luis199421/fuckhp/host/README.md

# freejet (host driver)

Python package that drives the FreeJet FJ-2 over USB. See `../docs/06-host-driver.md`.

```bash
pip install ./host[pdf]
freejet print document.pdf
```
