luis199421/fuckhp/docs/bom.csv

group | qty | part | spec | approx_usd_total | notes
mechanical | 3 | Smooth rod | 8 mm x 400 mm (500 mm for black + colour) | 7.50 | 2 carriage rails + the feed roller shaft
mechanical | 3 | Linear bearing | LM8UU | 2.00 | carriage
mechanical | 2 | Ball bearing | 608ZZ (8x22x7) | 1.00 | feed roller shaft
mechanical | 2 | Stepper motor | NEMA17, 34-40 mm, 1.8 deg, >=0.3 Nm | 18.00 | carriage and paper feed
mechanical | 2 | GT2 pulley | 20T, 5 mm bore, 6 mm belt | 3.00 | on the two motors
mechanical | 1 | GT2 idler | 20T toothed, 5 mm bore | 1.50 | carriage belt
mechanical | 1 | GT2 belt (open) | 6 mm, 1 m | 3.00 | carriage
mechanical | 1 | GT2 belt (closed loop) | 6 mm, 200 mm length | 1.50 | feed: motor 20T -> printed 60T on the roller
mechanical | 1 | Spring steel strip | 0.3 mm x 10-12.7 mm feeler-gauge strip, 25 cm | 3.00 | cut 4 leaves x 52 mm: they press the paper onto the roller
mechanical | 1 | Screw kit | M3 socket head x 8/12/16/20, ~40 M3 nuts, 6x M3x8 set screws; M2.5 x 6 self-tapping x4 | 5.00
mechanical | 1 | M5 bolt | M5 x 30 + nut + 2 washers | 0.50 | idler axle
mechanical | 1 | Extension spring | ~5 x 25 mm, light | 0.30 | returns the cap sled
mechanical | 2 | Lever microswitch | KW11-3Z with ~28 mm lever | 1.50 | home + paper sensor
mechanical | 1 | Push button | 12 mm panel button | 0.50 | front panel
mechanical | 1 | LED | 5 mm + 330 ohm | 0.20 | front panel
mechanical | 1 | Filament | PETG ~0.75 kg + TPU ~20 g | 14.00 | TPU: tires, cap, wiper, clamp pad
electronics | 1 | Raspberry Pi Pico 2 | RP2350 | 5.00
electronics | 2 | Stepper driver | TMC2209 StepStick (MS1/MS2 high = 1/16) | 8.00 | A4988 also works (louder)
electronics | 2 | Capacitor | 100 uF 25 V | 0.40 | one per stepper driver
electronics | 1 | Power supply | 12 V 5 A brick + 5.5x2.1 mm jack | 10.00
electronics | 2 | Buck module | MP1584, set to 5.0 V and 9.0 V | 2.00
electronics | 1 | Boost module | MT3608, set to 16.0 V | 1.00 | cartridge heater rail
electronics | 1 | P-MOSFET + NPN | IRF9540N + 2N3904 | 0.90 | switches the 16 V rail
electronics | 2 | Level shifter | CD4504BE (DIP-16) | 1.50 | 9 V and 16 V cartridge signals
electronics | 4 | Heater switch | AO3401A on SOT-23 adapter + 2N7000 | 1.20 | F3/F5 of each cartridge
electronics | 2 | Monostable | 74HCT123 (DIP-16) | 0.60 | heater pulse limiter (max ~3 us)
electronics | 1 | AND gate | 74HCT08 (DIP-14) | 0.20
electronics | 1 | Protection | 3 A polyfuse, 1N5822, 1N5819 | 0.60
electronics | 1 | Passives | resistors, 470 uF 25 V low-ESR, 10 uF, 100 nF, 680 pF C0G | 2.00
electronics | 1 | Board and connectors | 90 x 70 mm perfboard, JST-XH, headers | 3.00
electronics | 1 | Contact flex + cable | salvaged from a dead HP DeskJet 2130/2630/3630/4520 (or bought as a carriage spare part) | 0.00 | see 03-electronics.md
consumable | 1 | Black cartridge | HP 302 / 63 black (or XL) | 15.00 | refillable
consumable | 1 | Colour cartridge (optional) | HP 302 / 63 tri-colour (or XL) | 18.00 | for colour printing
