luis199421/fuckhp/cad/stl-kcmy/x_motor_bracket.stl

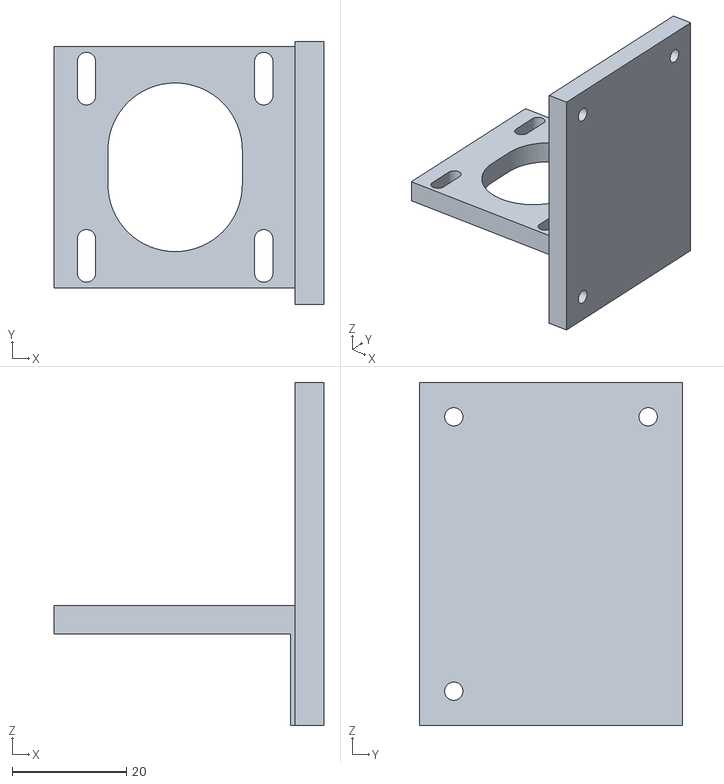
[picture p3: CAD file, 2026-11-01]
cad/stl-kcmy/x_motor_bracket.stl
47.1 x 46.0 x 60.0
