luis199421/fuckhp/cad/stl/leaf_clamp.stl

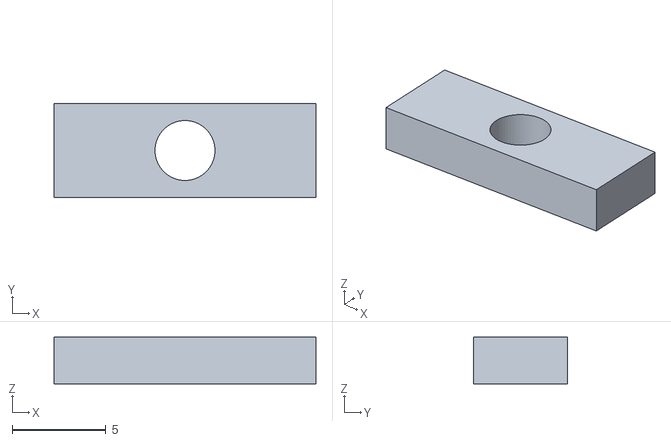
[picture p4: CAD file, 2026-11-01]
cad/stl/leaf_clamp.stl
14.0 x 5.00 x 2.50
