luis199421/fuckhp/cad/stl-kcmy/platen_1.stl

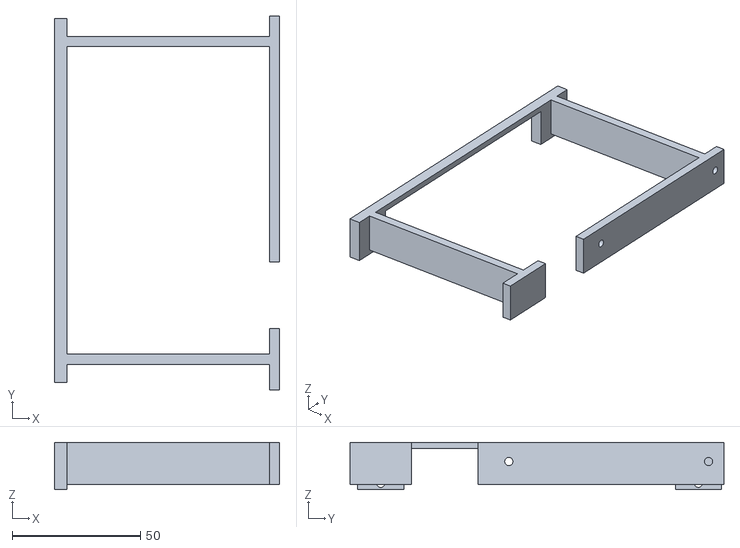
[picture p5: CAD file, 2026-11-01]
cad/stl-kcmy/platen_1.stl
88.0 x 146.0 x 18.5
