luis199421/fuckhp/cad/stl/roller_hub.stl

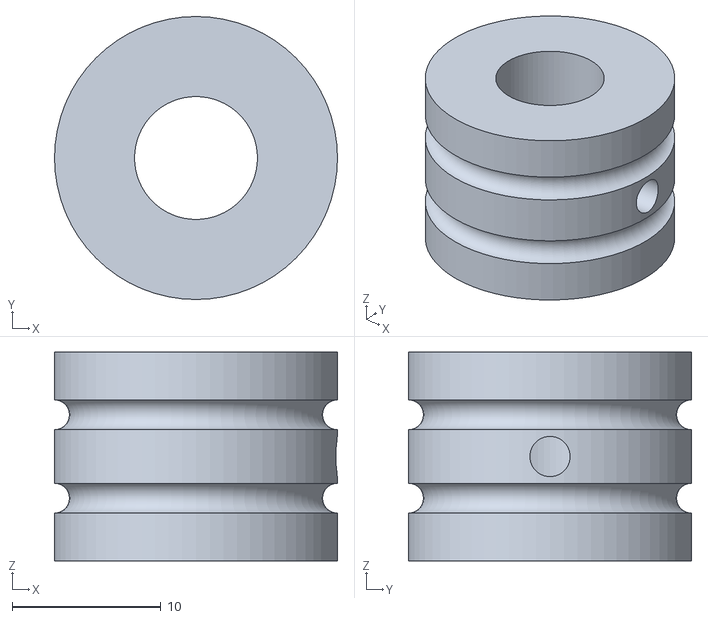
[picture p6: CAD file, 2026-11-01]
cad/stl/roller_hub.stl
19.0 x 19.0 x 14.0
