luis199421/fuckhp/cad/stl-kcmy/roll_core.stl

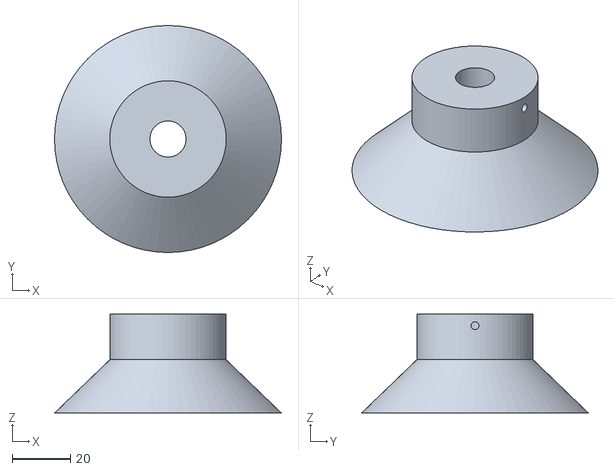
[picture p7: CAD file, 2026-11-01]
cad/stl-kcmy/roll_core.stl
78.0 x 78.0 x 34.0
