luis199421/fuckhp/cad/stl/leaf_bar_2.stl

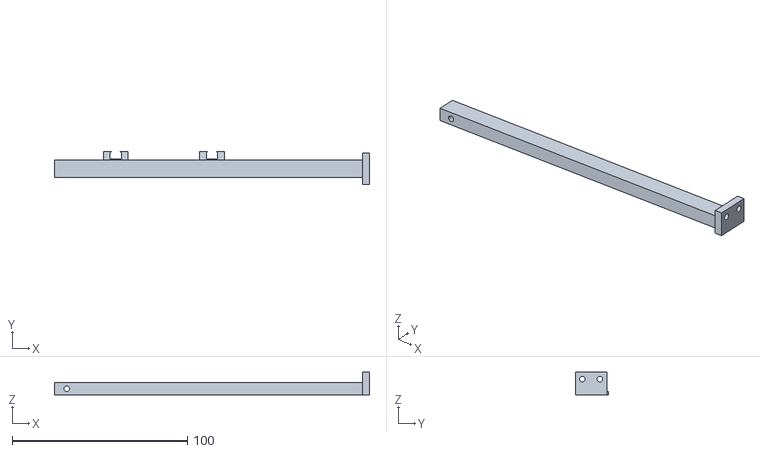
[picture p8: CAD file, 2026-11-01]
cad/stl/leaf_bar_2.stl
180.0 x 19.0 x 13.0
