luis199421/fuckhp/cad/stl-kcmy/platen_3.stl

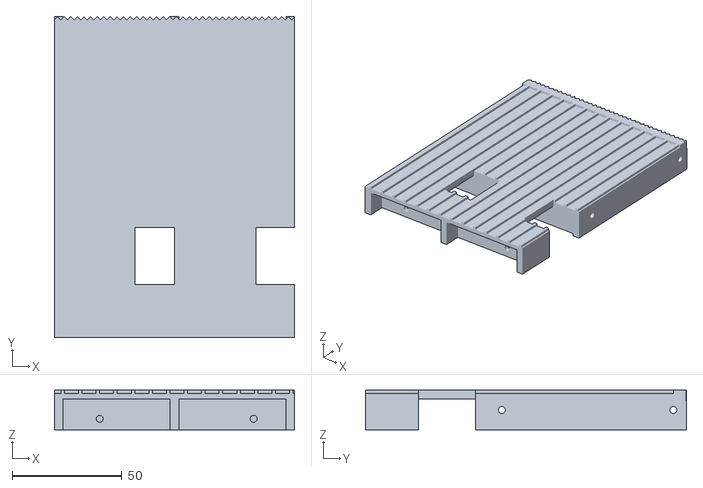
[picture p9: CAD file, 2026-11-01]
cad/stl-kcmy/platen_3.stl
109.3 x 146.0 x 18.0
