luis199421/fuckhp/cad/stl/leaf_bar_1.stl

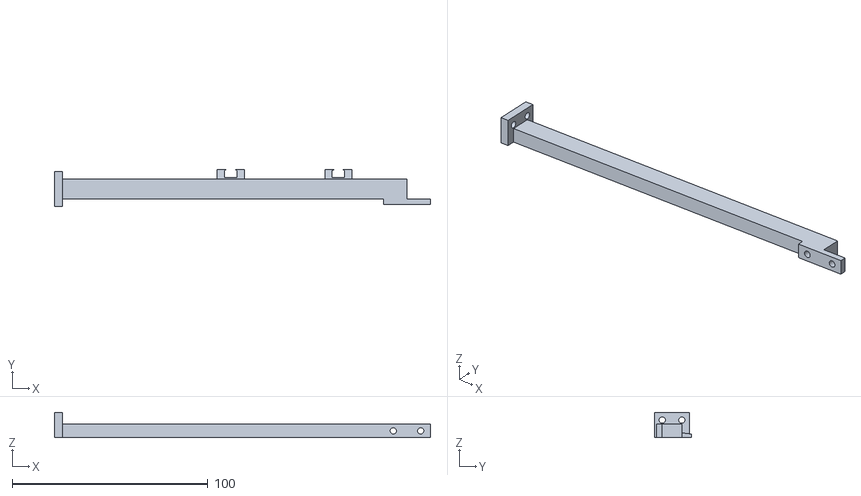
[picture p10: CAD file, 2026-11-01]
cad/stl/leaf_bar_1.stl
192.0 x 19.0 x 13.0
