luis199421/fuckhp/cad/stl-kcmy/carriage.stl

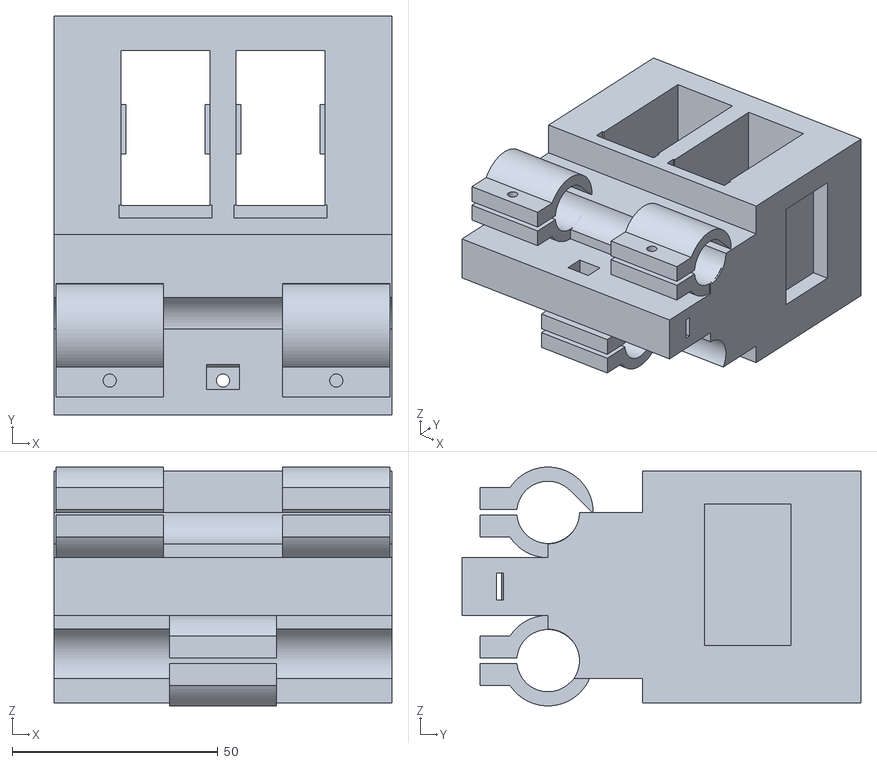
[picture p11: CAD file, 2026-11-01]
cad/stl-kcmy/carriage.stl
82.0 x 96.9 x 58.0
