luis199421/fuckhp/cad/stl/service_station_base.stl

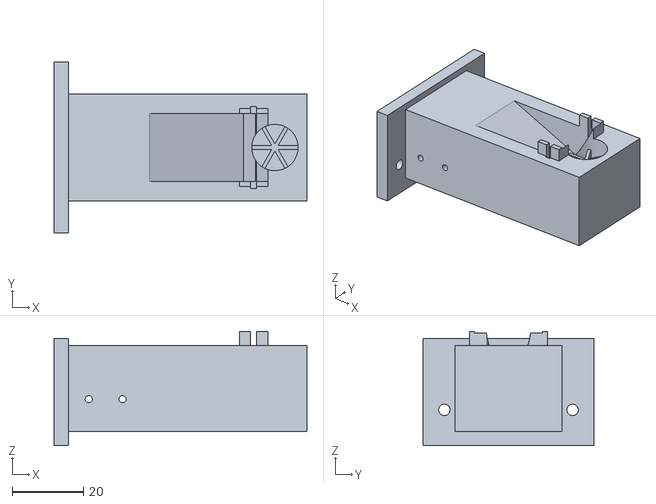
[picture p12: CAD file, 2026-11-01]
cad/stl/service_station_base.stl
71.0 x 48.0 x 32.0
