luis199421/fuckhp/cad/stl-kcmy/electronics_tray.stl

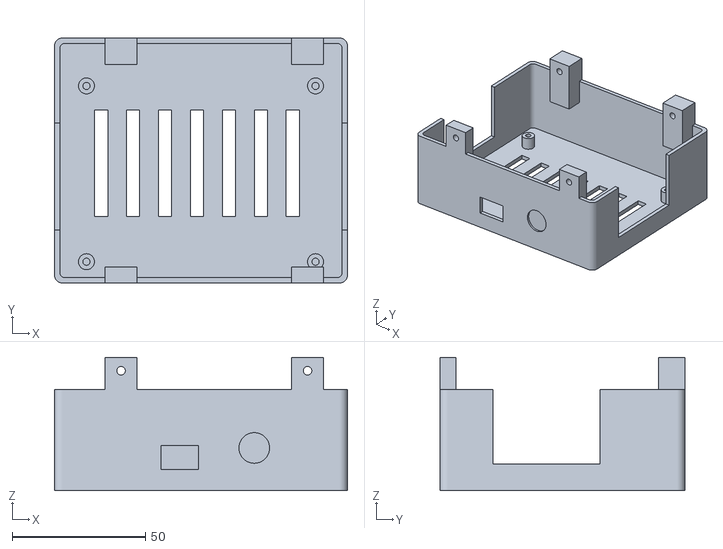
[picture p13: CAD file, 2026-11-01]
cad/stl-kcmy/electronics_tray.stl
110.0 x 92.0 x 50.0
