luis199421/fuckhp/cad/stl/tray_bracket.stl

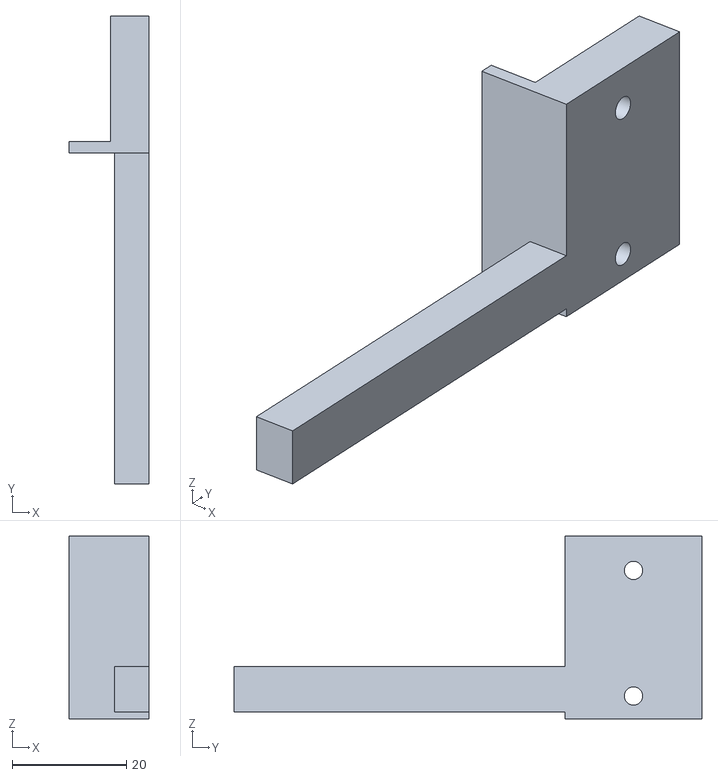
[picture p14: CAD file, 2026-11-01]
cad/stl/tray_bracket.stl
14.0 x 82.0 x 32.0
