luis199421/fuckhp/cad/stl-kcmy/service_station_sled.stl

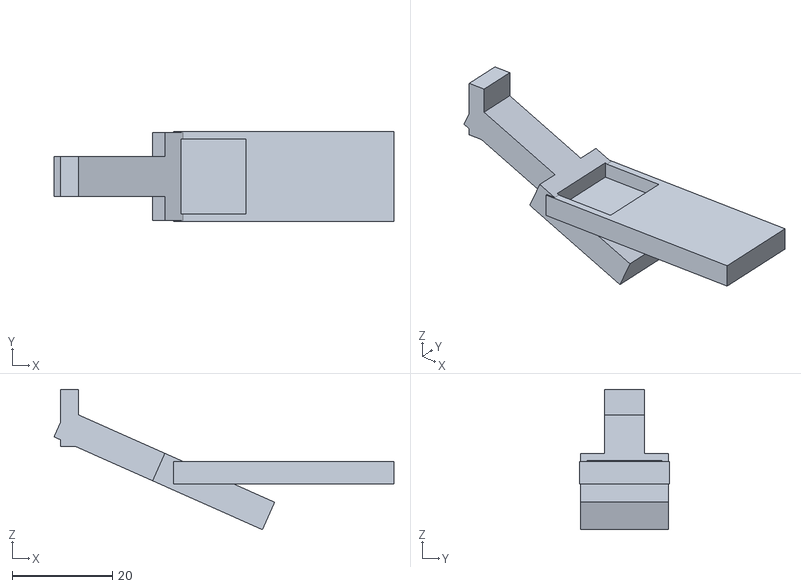
[picture p15: CAD file, 2026-11-01]
cad/stl-kcmy/service_station_sled.stl
67.9 x 18.0 x 28.0
