luis199421/fuckhp/cad/stl/side_plate_left.stl

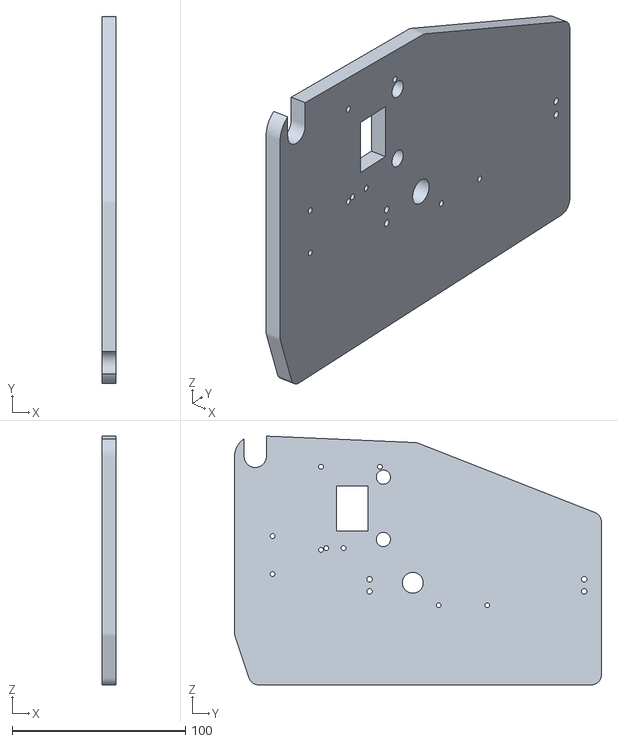
[picture p16: CAD file, 2026-11-01]
cad/stl/side_plate_left.stl
8.00 x 212.0 x 143.7
