luis199421/fuckhp/cad/stl-kcmy/x_idler_bracket.stl

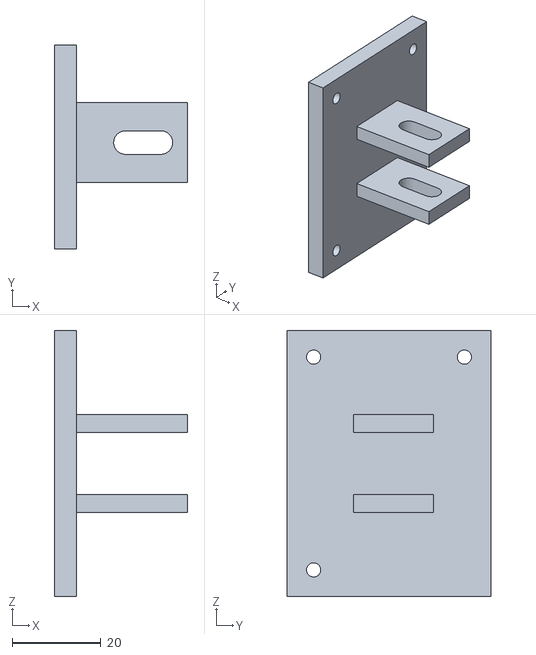
[picture p17: CAD file, 2026-11-01]
cad/stl-kcmy/x_idler_bracket.stl
30.0 x 46.0 x 60.0
