luis199421/fuckhp/cad/stl/platen_3.stl

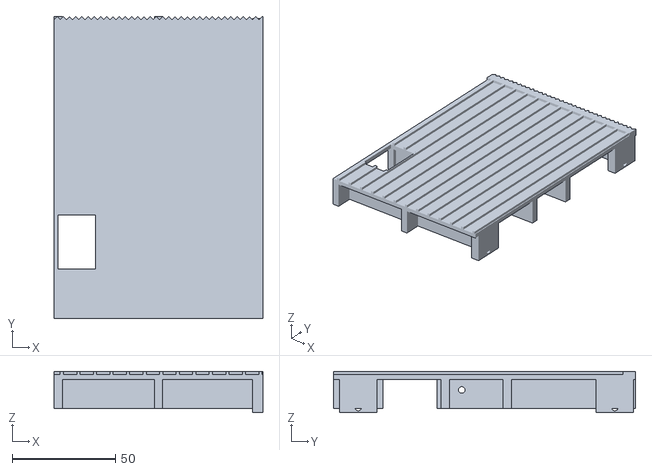
[picture p18: CAD file, 2026-11-01]
cad/stl/platen_3.stl
101.0 x 146.0 x 20.0
