luis199421/fuckhp/cad/stl-kcmy/paper_tray_1.stl

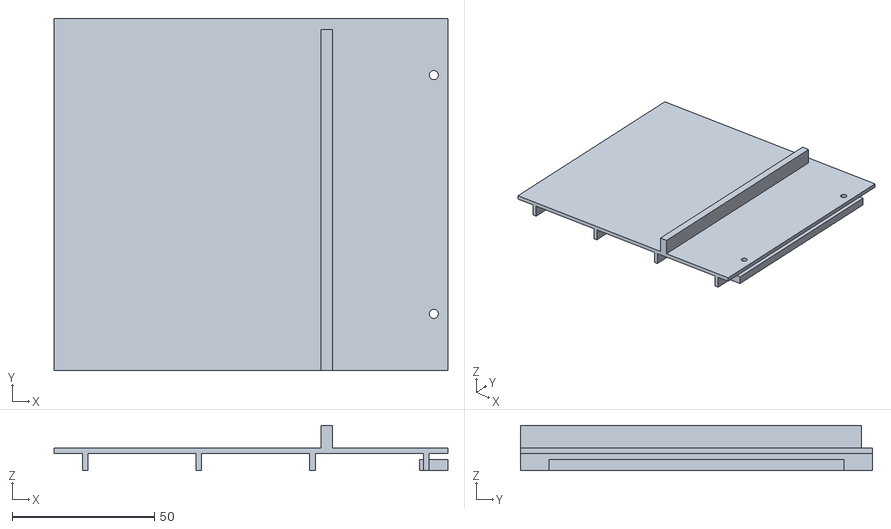
[picture p19: CAD file, 2026-11-01]
cad/stl-kcmy/paper_tray_1.stl
138.7 x 124.0 x 16.0
