luis199421/fuckhp/cad/stl/sensor_bracket.stl

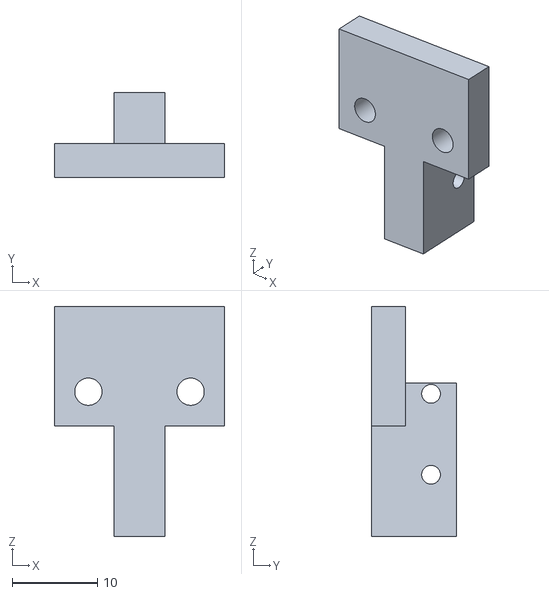
[picture p20: CAD file, 2026-11-01]
cad/stl/sensor_bracket.stl
20.0 x 10.0 x 27.0
