luis199421/fuckhp/cad/stl-kcmy/leaf_bar_1.stl

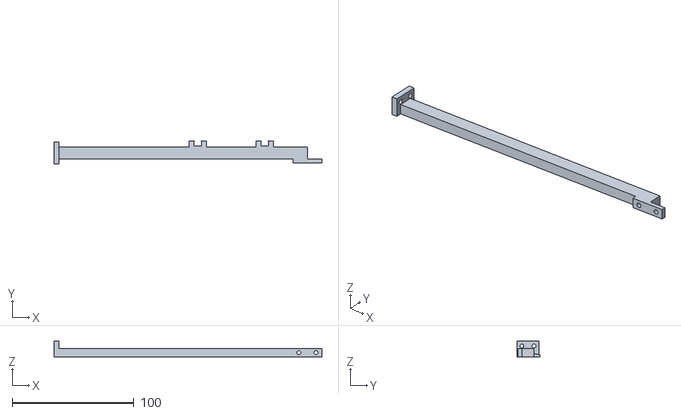
[picture p21: CAD file, 2026-11-01]
cad/stl-kcmy/leaf_bar_1.stl
220.0 x 19.0 x 13.0
