luis199421/fuckhp/cad/stl-kcmy/service_station_base.stl

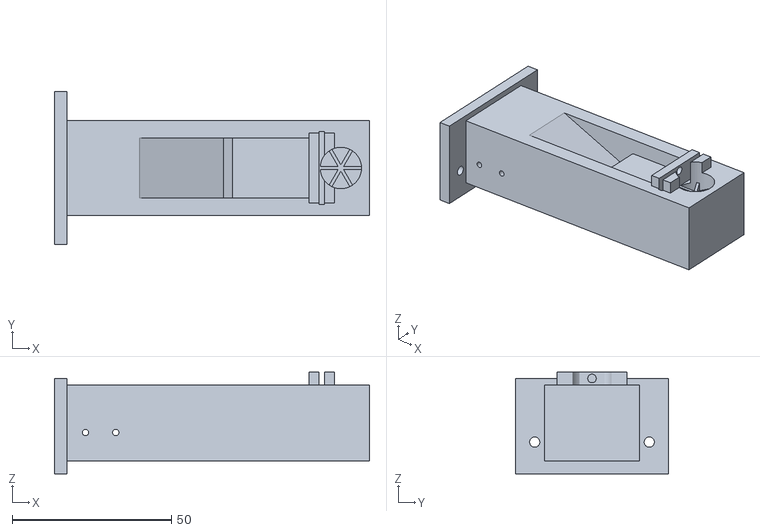
[picture p22: CAD file, 2026-11-01]
cad/stl-kcmy/service_station_base.stl
99.0 x 48.0 x 32.0
