luis199421/fuckhp/cad/stl/platen_2.stl

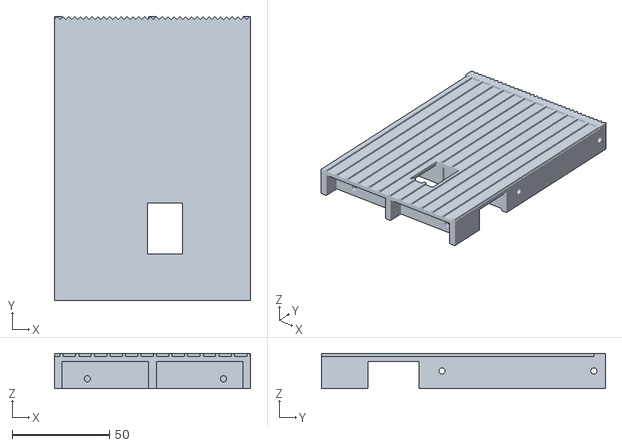
[picture p23: CAD file, 2026-11-01]
cad/stl/platen_2.stl
101.0 x 146.0 x 18.0
