luis199421/fuckhp/cad/stl/paper_tray_2.stl

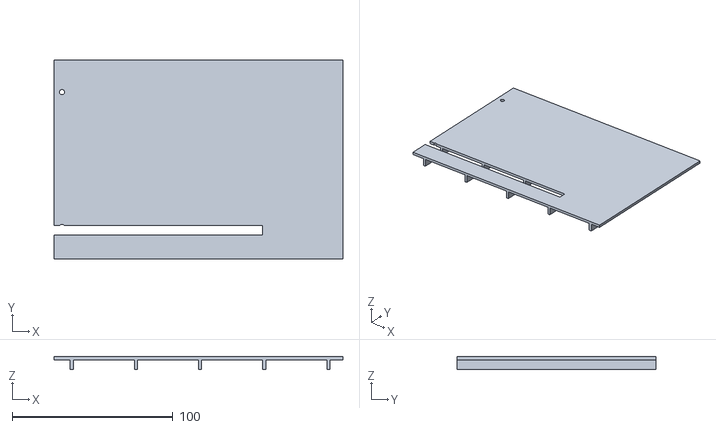
[picture p24: CAD file, 2026-11-01]
cad/stl/paper_tray_2.stl
180.0 x 124.0 x 8.00
