luis199421/fuckhp/cad/stl-kcmy/rod_collar.stl

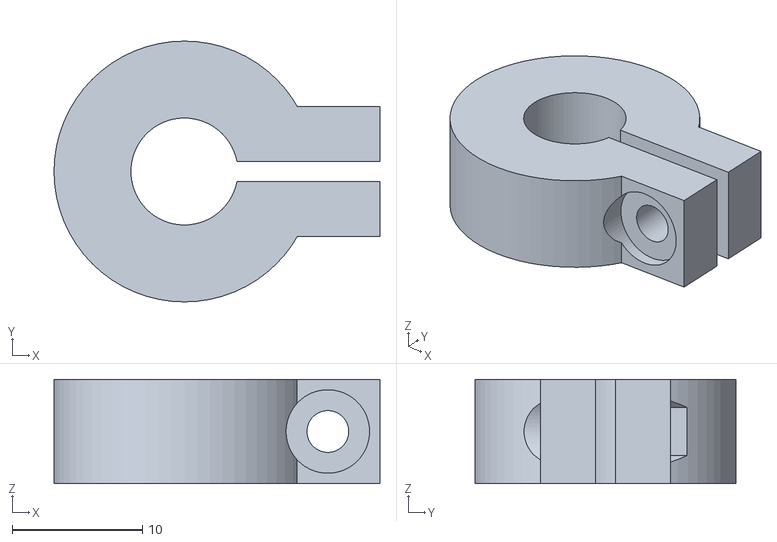
[picture p25: CAD file, 2026-11-01]
cad/stl-kcmy/rod_collar.stl
25.0 x 20.0 x 8.00
