luis199421/fuckhp/cad/stl-kcmy/gt2_pulley_60t.stl

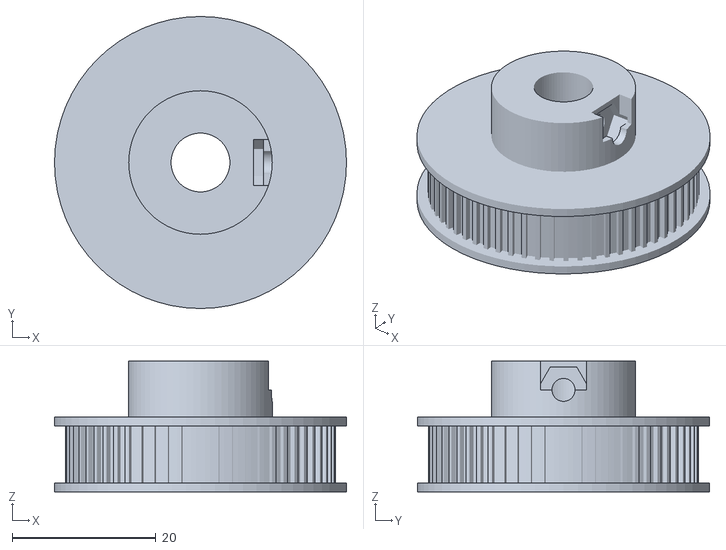
[picture p26: CAD file, 2026-11-01]
cad/stl-kcmy/gt2_pulley_60t.stl
40.7 x 40.7 x 18.2
