luis199421/fuckhp/cad/stl-kcmy/platen_4.stl

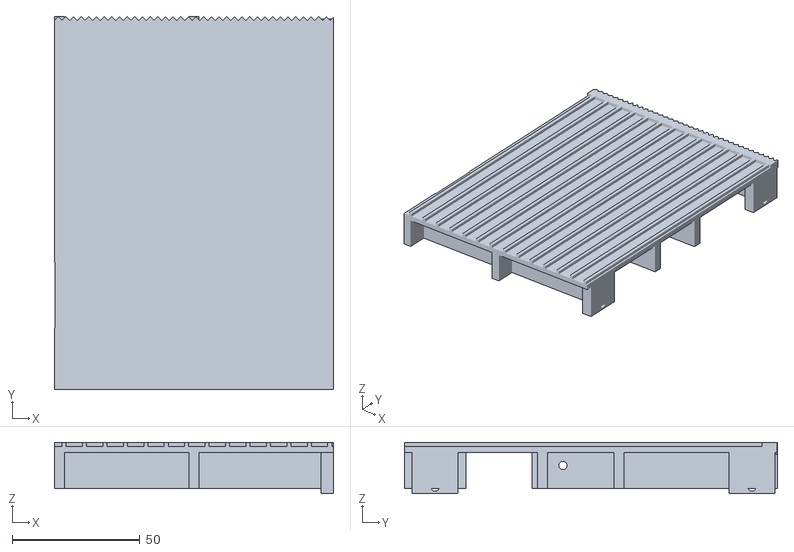
[picture p27: CAD file, 2026-11-01]
cad/stl-kcmy/platen_4.stl
109.3 x 146.0 x 20.0
