luis199421/fuckhp/cad/stl/carriage.stl

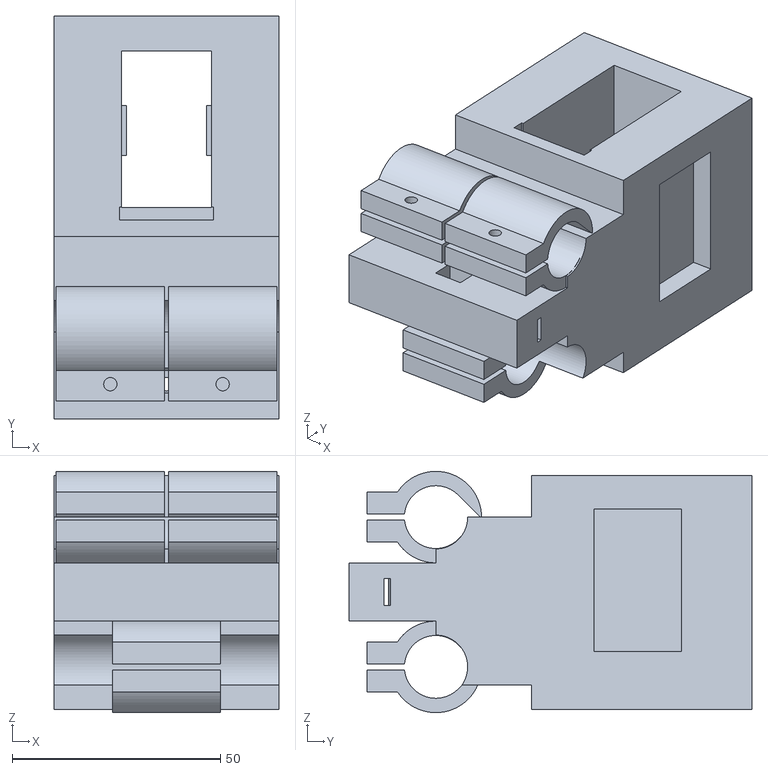
[picture p28: CAD file, 2026-11-01]
cad/stl/carriage.stl
54.0 x 96.9 x 58.0
