luis199421/fuckhp/cad/stl-kcmy/leaf_bar_2.stl

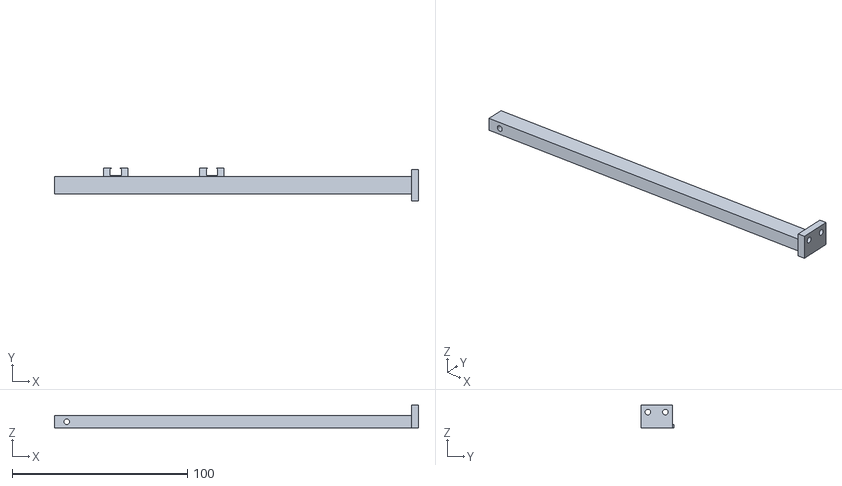
[picture p29: CAD file, 2026-11-01]
cad/stl-kcmy/leaf_bar_2.stl
208.0 x 19.0 x 13.0
