luis199421/fuckhp/cad/stl/roll_spindle.stl

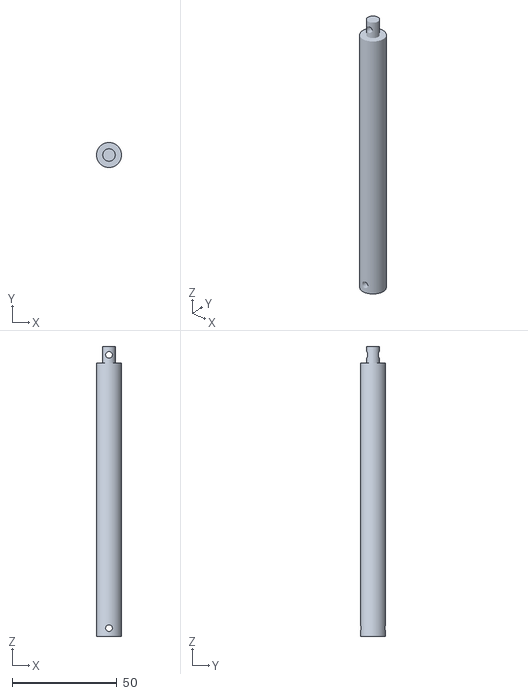
[picture p30: CAD file, 2026-11-01]
cad/stl/roll_spindle.stl
12.0 x 12.0 x 138.7
