luis199421/fuckhp/cad/stl/paper_tray_1.stl

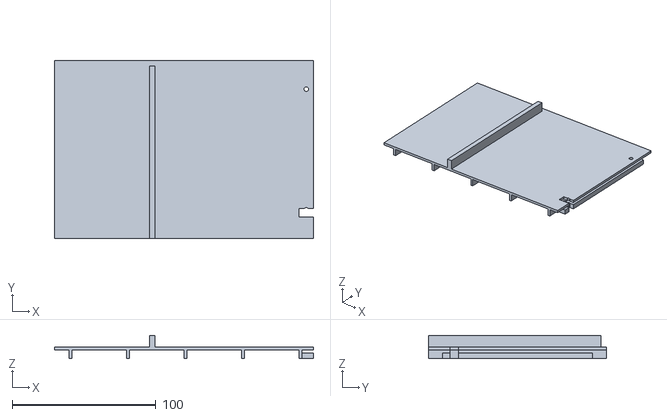
[picture p31: CAD file, 2026-11-01]
cad/stl/paper_tray_1.stl
180.0 x 124.0 x 16.0
