luis199421/fuckhp/cad/stl/platen_1.stl

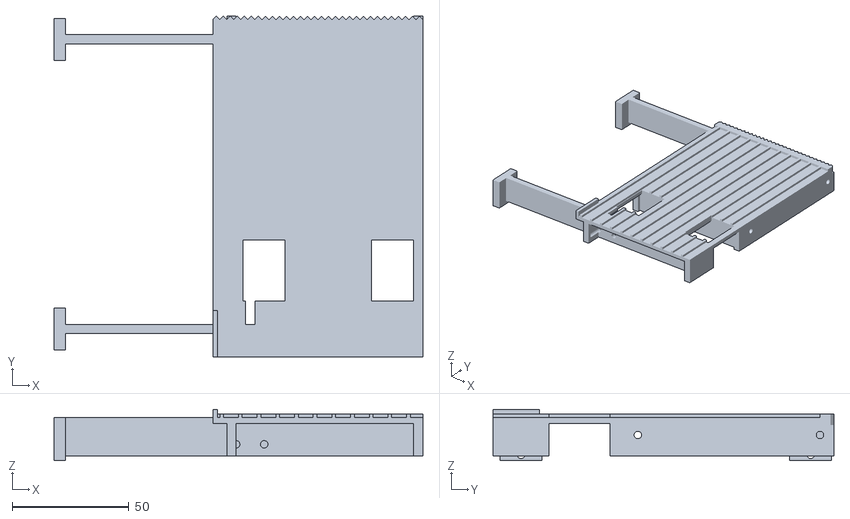
[picture p33: CAD file, 2026-11-01]
cad/stl/platen_1.stl
158.0 x 146.0 x 22.0
