luis199421/fuckhp/cad/stl-kcmy/roll_spindle.stl

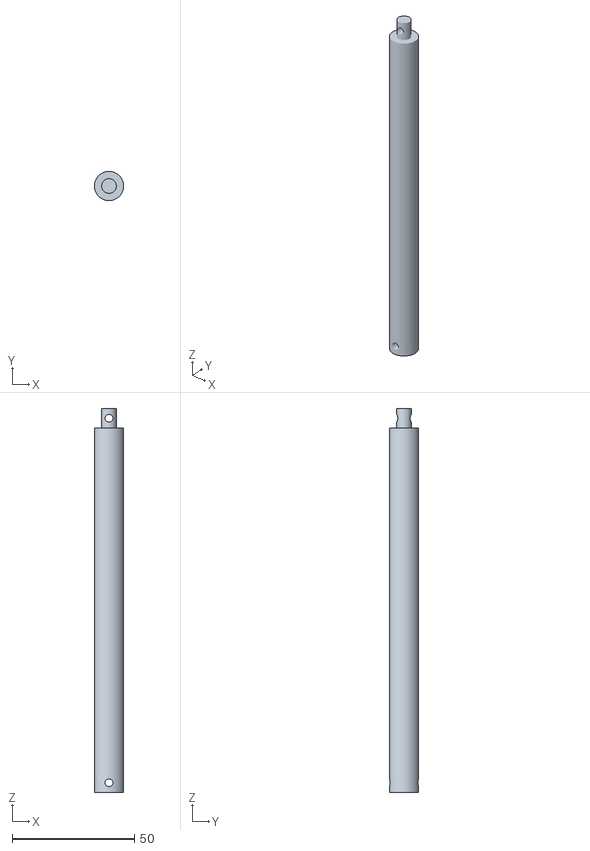
[picture p34: CAD file, 2026-11-01]
cad/stl-kcmy/roll_spindle.stl
12.0 x 12.0 x 157.3
