luis199421/fuckhp/cad/stl/paper_tray_right.stl

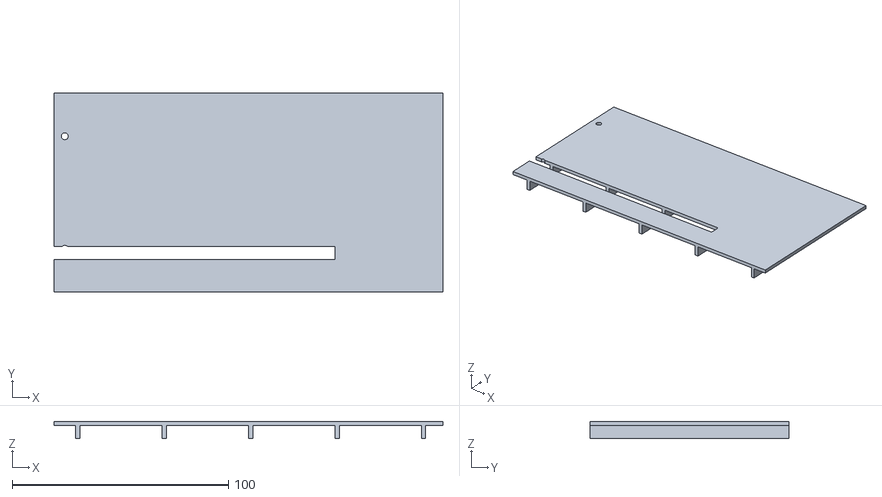
[picture p36: CAD file, 2026-11-01]
cad/stl/paper_tray_right.stl
180.0 x 92.0 x 8.00
