luis199421/fuckhp/cad/stl-kcmy/paper_tray_2.stl

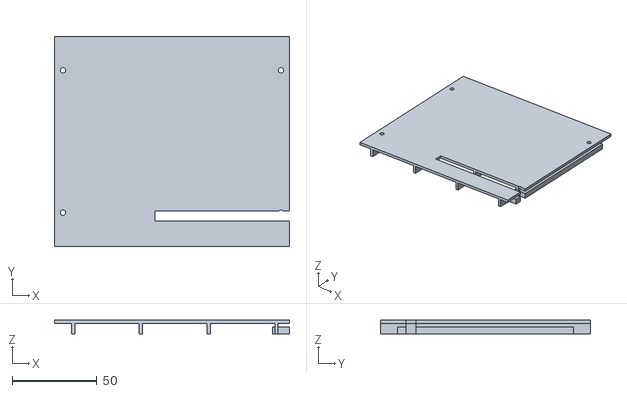
[picture p37: CAD file, 2026-11-01]
cad/stl-kcmy/paper_tray_2.stl
138.7 x 124.0 x 8.00
