luis199421/fuckhp/cad/stl/paper_guide.stl

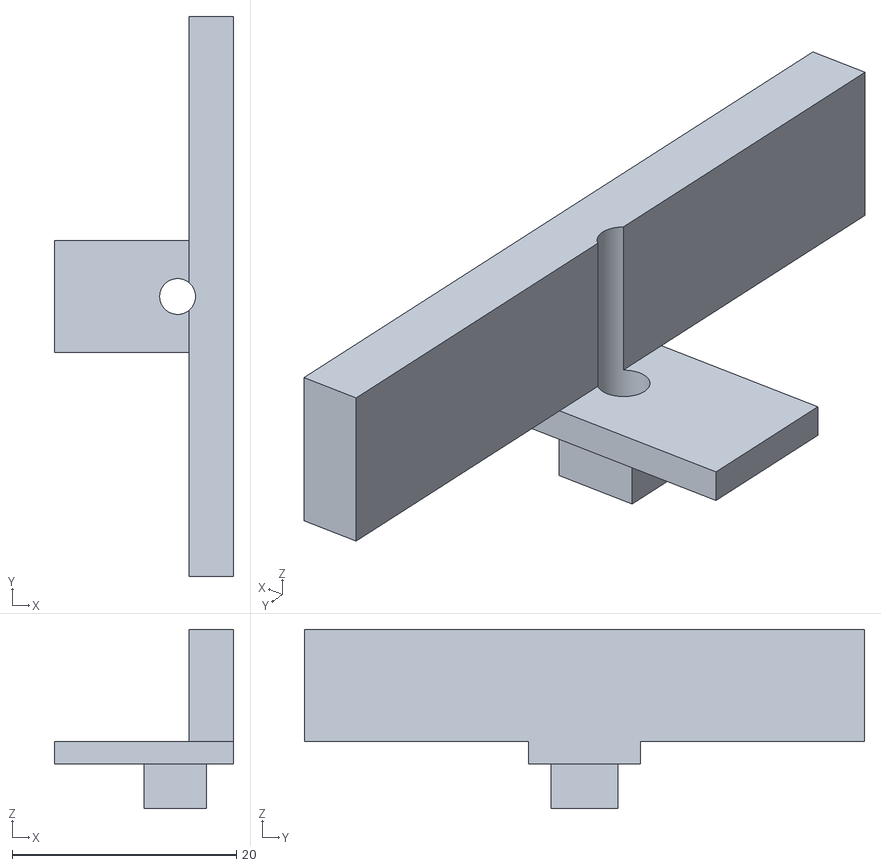
[picture p38: CAD file, 2026-11-01]
cad/stl/paper_guide.stl
16.0 x 50.0 x 16.0
