luis199421/fuckhp/cad/stl/service_station_sled.stl

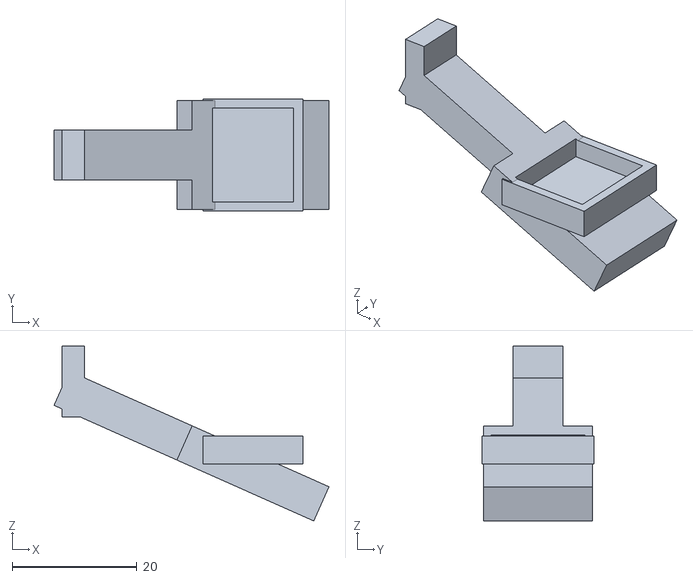
[picture p39: CAD file, 2026-11-01]
cad/stl/service_station_sled.stl
44.1 x 18.0 x 28.0
