luis199421/fuckhp/cad/stl-kcmy/roller_tire_TPU.stl

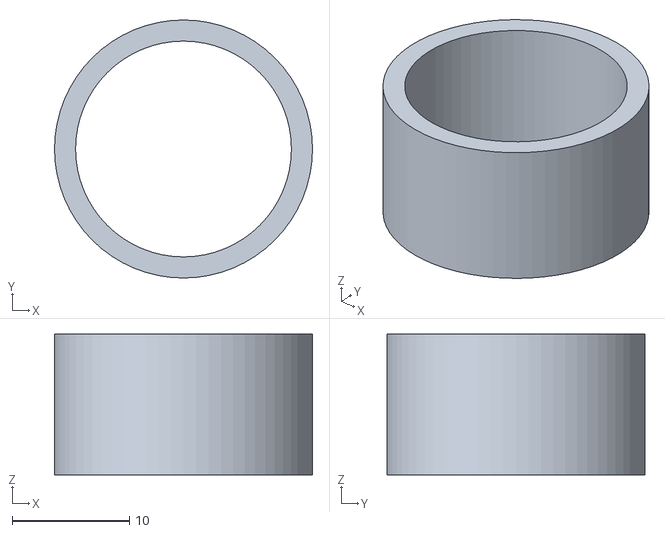
[picture p40: CAD file, 2026-11-01]
cad/stl-kcmy/roller_tire_TPU.stl
22.0 x 22.0 x 12.0
