luis199421/fuckhp/cad/stl-kcmy/service_cap_TPU.stl

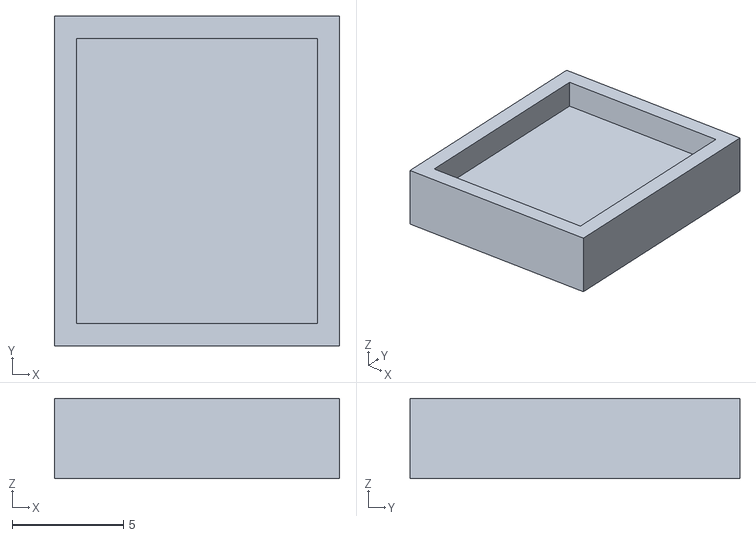
[picture p41: CAD file, 2026-11-01]
cad/stl-kcmy/service_cap_TPU.stl
12.8 x 14.8 x 3.60
