luis199421/fuckhp/cad/stl-kcmy/service_wiper_TPU.stl

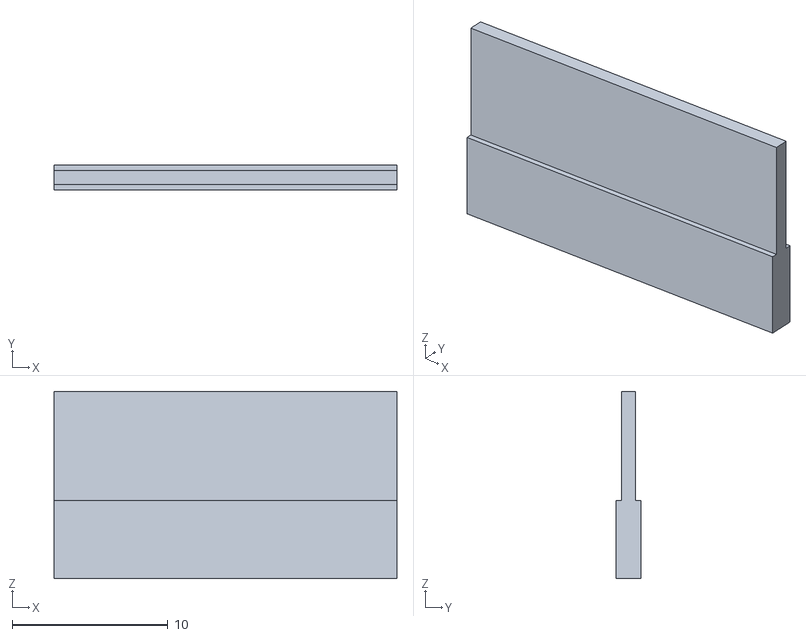
[picture p42: CAD file, 2026-11-01]
cad/stl-kcmy/service_wiper_TPU.stl
22.0 x 1.60 x 12.0
