luis199421/fuckhp/cad/stl-kcmy/carriage_pad.stl

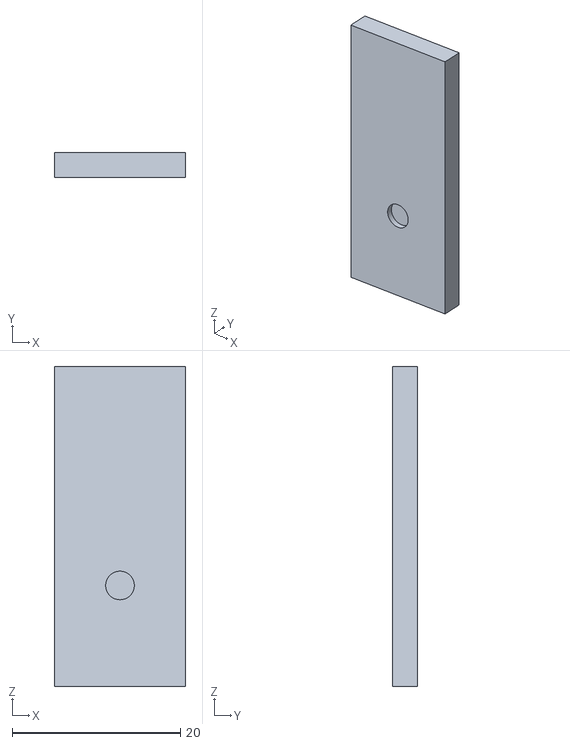
[picture p43: CAD file, 2026-11-01]
cad/stl-kcmy/carriage_pad.stl
15.6 x 3.00 x 38.0
