luis199421/fuckhp/(list of files, cad)

Other CAD files:
cad/stl-kcmy/side_plate_right.stl
cad/stl/side_plate_right.stl
cad/stl/x_motor_bracket.stl
cad/stl/electronics_tray.stl
cad/stl-kcmy/tray_bracket.stl
cad/stl-kcmy/sensor_bracket.stl
cad/stl/roll_core.stl
cad/stl/rod_collar.stl
cad/stl/x_idler_bracket.stl
cad/stl-kcmy/side_plate_left.stl
cad/stl/gt2_pulley_60t.stl
cad/stl-kcmy/roller_hub.stl
cad/stl/roller_tire_TPU.stl
