luis199421/fuckhp/docs/img/assembly_front.png

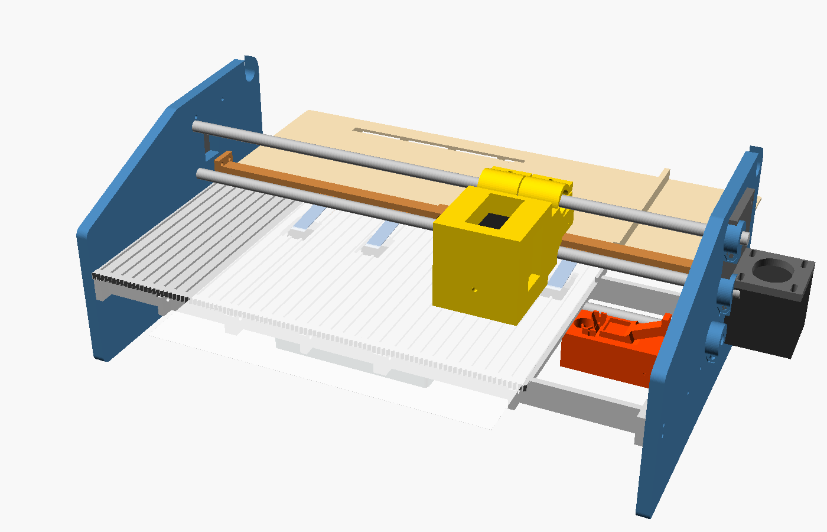
docs/img/assembly_front.png
