luis199421/fuckhp/docs/img/assembly_rear.png

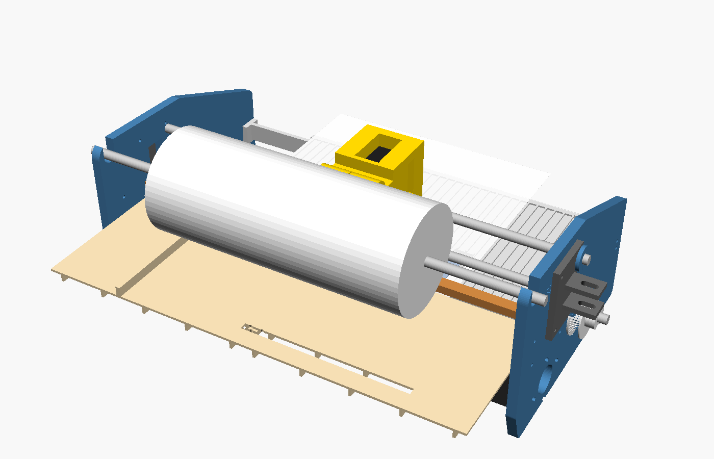
docs/img/assembly_rear.png
