luis199421/fuckhp/docs/img/assembly_side.png

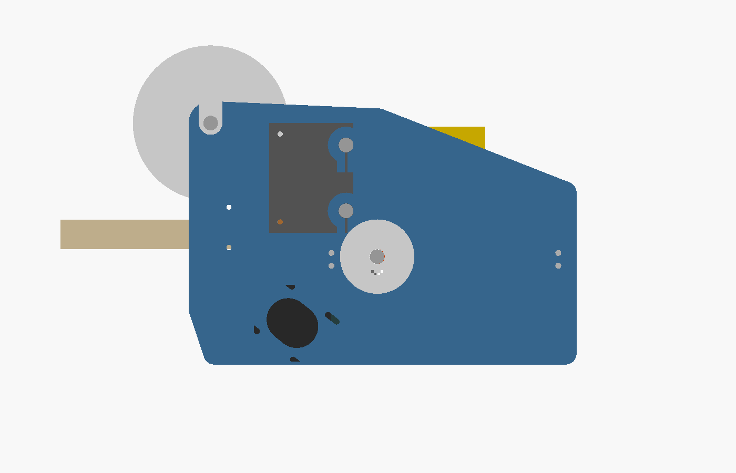
docs/img/assembly_side.png
