luis199421/fuckhp/firmware/src/tusb_config.h

#pragma once

#define CFG_TUSB_RHPORT0_MODE   OPT_MODE_DEVICE
#define CFG_TUSB_OS             OPT_OS_PICO
#define CFG_TUD_ENDPOINT0_SIZE  64

#define CFG_TUD_CDC             1
#define CFG_TUD_MSC             0
#define CFG_TUD_HID             0
#define CFG_TUD_MIDI            0
#define CFG_TUD_VENDOR          0

// big RX FIFO keeps the bulk pipe busy while the parser copies into the ring
#define CFG_TUD_CDC_RX_BUFSIZE  4096
#define CFG_TUD_CDC_TX_BUFSIZE  1024
#define CFG_TUD_CDC_EP_BUFSIZE  64
