luis199421/fuckhp/(commit log)

2026-11-01 Add FreeJet host driver and Pico 2 firmware
    Host (Python): USB protocol, PackBits swath encoder, document rasterizer
    (PDF/image/text), printer emulator, calibration pages, CLI and CUPS
    filter/backend. Firmware (C, pico-sdk): HP45 fire engine on PIO + core1,
    stepper ISR with column triggers, job queue/executor, flash params.
    The firmware's portable data path is tested on the host against the
    Python encoder.
    Claude-Session: https://claude.ai/code/session_01DB2YxobjvZHC9b1eGHdHjZ
    [hp45_holes.csv, hp45_pads.csv]
2026-11-01 Add parametric OpenSCAD frame, carriage and paper path (23 printable parts)
    Side plates on eight 8 mm rods, LM8UU carriage with HP45 pocket and head
    board mount, ribbed 3-piece platen, roller hubs/TPU tires, 76T GT2 feed
    pulleys on a 400 mm loop, service station (cap sled + home switch, wiper,
    spittoon), sensor bracket, electronics tray, paper tray and roll holder.
    Includes assembly model, STL exports and a carriage sweep collision check.
    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
    [assembly.scad, carriage.scad, carriage.stl, carriage_pad.scad, carriage_pad.stl, electronics_tray.scad, electronics_tray.stl, fj.scad]
2026-11-01 Add docs, printhead board netlist, CUPS PPD/installer and CI
    - Build guide: design rationale, BOM (~$135 + cartridge), printing,
    electronics, assembly, firmware, driver, calibration, troubleshooting,
    protocol spec and roadmap.
    - Printhead board: full netlist with HP45 pad numbers and a generated
    KiCad contact footprint (pad map from Ytec3D, GPL-3.0).
    - CUPS: PPD, filter/backend wrappers and install script; the filter now
    places imageable-area rasters on the full page (verified with a real
    CUPS + Ghostscript run in the tests).
    - Bidirectional test page now deterministic; row-gap calibration sign fixed.
    - CI: host tests, firmware build, STL export.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
    [bom.csv, check_collisions.scad]
2026-11-01 Correct Openprinter comparison from its Crowd Supply page; add Pi print server
    Use the real published specs (Pi Zero W + STM32, HP 63/302, CC BY-NC-SA
    4.0, Wi-Fi/USB/Bluetooth, 24 V, 50x10x11 cm). Adopt their CUPS-on-a-Pi
    idea as an optional add-on: a script that turns a Pi Zero 2 W into a
    shared FreeJet queue for phones, Windows and macOS.
    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
2026-11-01 Keep the printer Pico 2-only; network sharing runs on the host computer
    Drop the Pi Zero 2 W print-server suggestion from the main path: the
    sharing script now targets the Linux computer the printer is plugged
    into, so no extra hardware is needed.
    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
2026-11-01 Print everything that can be printed reliably
    - Platen is now a bolted 3-segment printed beam with slotted end flanges
    (head-gap adjustment) that also braces the frame: 2 steel rods fewer.
    - Printed split collars replace 16 bought shaft collars.
    - Closed, clamped LM8UU housings and printed GT2 teeth replace zip ties.
    - TPU cap and wiper, baffled spittoon replace foam, rubber and felt.
    - Printed roll spindle replaces the roll-holder rod.
    - Docs: printed-vs-bought rationale, updated BOM (~$120 + cartridge),
    print list (27 parts) and assembly steps. Collision check still clean.
    Claude-Session: https://claude.ai/code/session_01DB2Yxobj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
    [assembly.scad, bom.csv, carriage.scad, carriage.stl, electronics_tray.scad, electronics_tray.stl, fj.scad, gt2_pulley_76t.stl]
2026-11-01 Add assembly animation (GIF + MP4) rendered from the CAD
    cad/animation.scad flies the real parts in, step by step in assembly
    order, then runs a print demo; tools/render_animation.py renders the
    frames with OpenSCAD, adds captions and encodes GIF/MP4 with ffmpeg.
    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
    [animation.scad]
2026-11-01 Grayscale and colour: 1-4 HP45-format cartridges with different inks
    Host: ink sets K / KLK (black + light black) / CMY / CMYK, colour
    separation with grey-component replacement and total-ink limit, tone
    curve (gamma), per-plane halftoning, multi-plane passes (288 rows, planes
    PackBits'd separately), --inks/--gamma CLI options, colour previews,
    CUPS RGB raster + PPD ColorModel/FJInkSet/FJGamma, head alignment test
    page and calibrate head-x/head-y.
    Firmware: composer drives up to 4 heads (own X offset, +-6 row vertical
    alignment via spare nozzles); PIO shifts 4 data lines in parallel so
    firing time doesn't grow; shared address/clock/fire lines; TSR mux;
    new params n_heads, headN_x_um, headN_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
    [cli.py, color.py, compose.c, compose.h, config.h, cups_filter.py, cups_raster.py, emulator.py]
2026-11-01 Colour/grayscale hardware: parametric 1-4 cartridge build, docs
    - CAD: N_HEADS parameter (make -C cad N_HEADS=4 -> stl-4heads): carriage
    with one pocket and narrow head board per cartridge, frame 56 mm wider
    per extra cartridge, platen/tray/spindle split to fit a 220 mm bed,
    one cap per cartridge. Collision check passes for 1 and 4 cartridges.
    - Firmware: each cartridge is spat over the single spittoon in turn.
    - freejet setup --inks sets n_heads + frame geometry; fixed spit_x_um
    default (32 mm) for the current service station.
    - Docs: grayscale & colour guide (inks, refilling, alignment), pin map
    for 4 data lines + TSR mux, narrow head board, protocol, BOM options.
    - Assembly anim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
    [animation.scad, assembly.scad, bom.csv, carriage.scad, carriage.stl, carriage_pad.stl, check_collisions.scad, electronics_tray.scad]
2026-11-01 Add simulated CMYK and grayscale print to the colour guide
    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
2026-11-01 Show the simulated colour prints in the colour guide
    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
2026-11-01 Switch to HP 63/302 cartridges (black + tri-colour), like Openprinter
    Drive scheme from SpriteMods' MagicBrush/PrintSpider (Sprite_tm's beer-ware
    printercart_simple): 12 cartridge lines + 4 heater lines, played as a
    14-bit waveform at 3.33 MHz by a 2-instruction PIO program fed by DMA,
    double-buffered on core1. Black and colour cartridges share the data and
    clock lines and fire one after the other within each column.
    - firmware: hp302.c (nozzle bit maps + waveform generator, checked
    sample-for-sample against the original driver), new composer with
    five nozzle columns (black rows 0/1, C, M, Y), cartridges param, sheet
    loading against the roller nip, sheet-tail guard, new pin map.
    - hos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
    [hp45_holes.csv, hp45_pads.csv]
2026-11-01 FJ-2: single-roller frame, two-cartridge carriage, docs for HP 63/302
    Mechanics (Openprinter-style simplification):
    - one feed roller with 4 TPU tires, 60T printed pulley + 200 mm GT2 loop (3:1)
    - 4 spring-steel leaves on a printed leaf bar instead of pinch shaft,
    exit rollers and star wheels; 3 steel rods in total
    - roll spindle drops into keyhole slots in the side plates
    - carriage pockets for one cartridge (K or CMY) or two (KCMY, CARTS=KCMY,
    STLs in cad/stl-kcmy), contact-flex recess per pocket
    Docs, BOM and tooling rewritten for the HP 63/302 cartridges: electronics,
    assembly, firmware, calibration (test colors, calibrate color-x/cmy-pitch/
    k-dy), troubleshooting, roadmap, grayscal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
    [animation.scad, assembly.scad, bom.csv, carriage.scad, carriage.stl, carriage_pad.stl, check_collisions.scad, electronics_tray.scad]
2026-11-01 Re-render the assembly animation for FJ-2
    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
